InfinityTech100/Bike-Mini-speedo/Hardware/Bike/Bike1.png

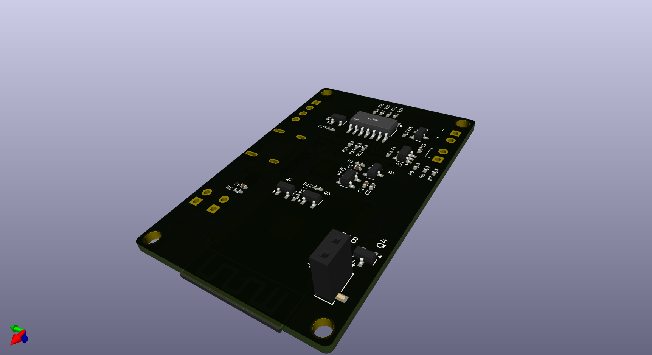
Hardware/Bike/Bike1.png
