InfinityTech100/Bike-Mini-speedo/Hardware/Bike/Bike2.png

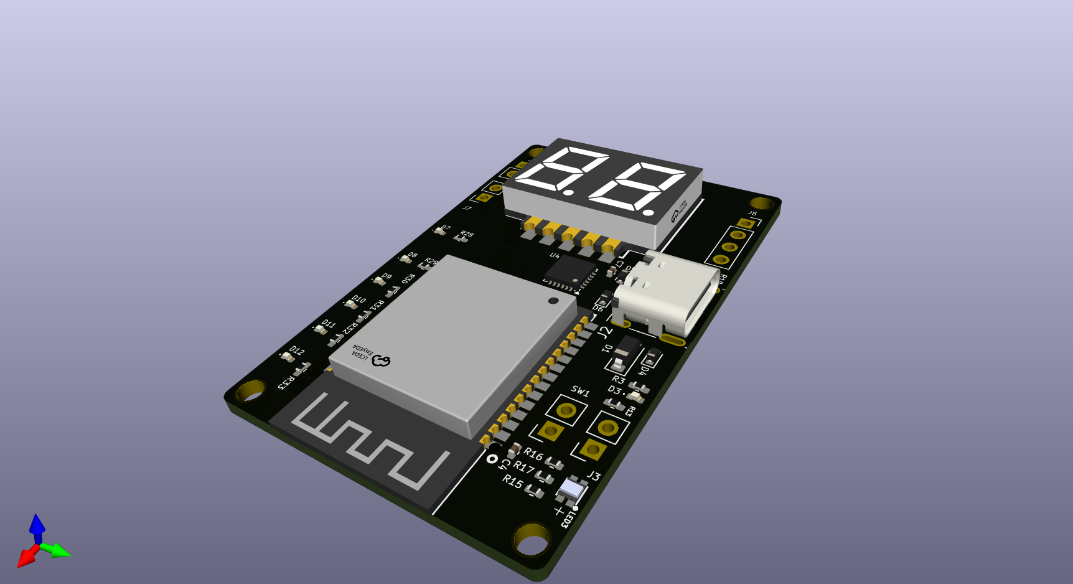
Hardware/Bike/Bike2.png
