InfinityTech100/Bike-Mini-speedo/Hardware/Bike/Bike3.png

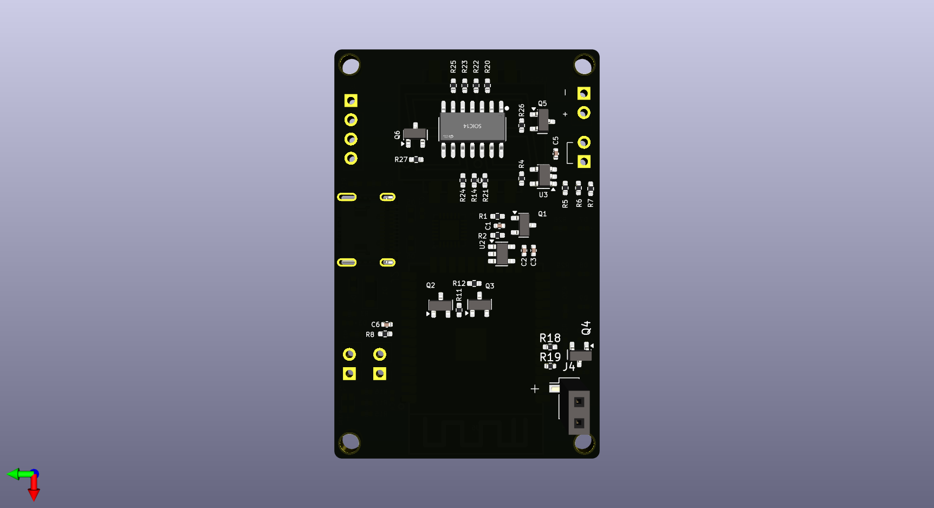
Hardware/Bike/Bike3.png
