InfinityTech100/Bike-Mini-speedo/Hardware/Bike/Bike4.png

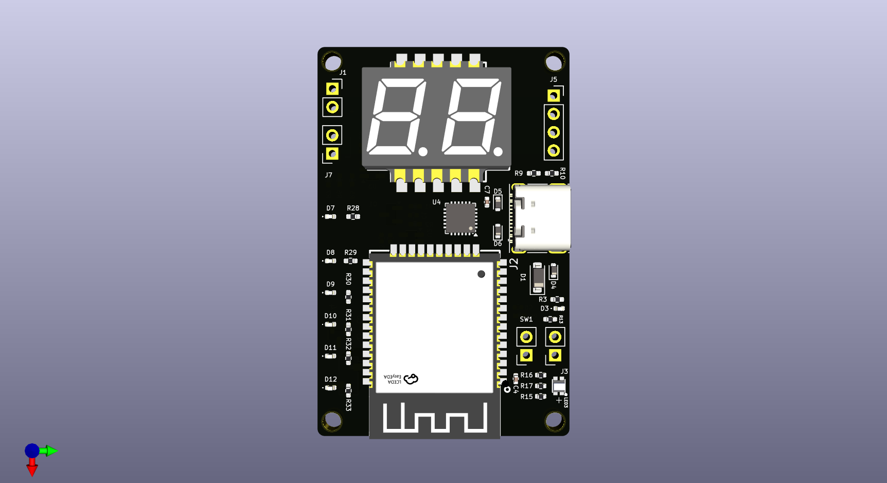
Hardware/Bike/Bike4.png
