InfinityTech100/Bike-Mini-speedo/Documents/BOM _v2.xlsx

Components | Size | Price | Qty | Total Price ($) | Link
Object Detection LED | 2.8 x 2.4 x 1.75 mm | 0.2 | 6 | 1.2 | https://www.lcsc.com/product-detail/Light-Emitting-Diodes-LED_Vishay-Intertech-VLMV3100-GS08_C2979783.html
Battery RGB LED | 3.5 x 3.5 x 1.9 | 0.1 | 1 | 0.1 | https://www.lcsc.com/product-detail/Light-Emitting-Diodes-LED_Worldsemi-WS2812B-MINI-V3-W_C527089.html
Digital LED | 19 x 25.1 x 3.85 mm | 5.18 | 1 | 5.18 | https://www.lcsc.com/product-detail/Led-Segment-Display_American-Opto-Plus-LED-SMC562LB-G-W_C6228974.html
GPS | 26 x 35 x 3 mm | 0.7 | 1 | 0.7 | https://ko.aliexpress.com/item/1005005396070425.html?src=google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
Buzzer | 5 x 5 x 2 mm | 0.5 | 1 | 0.5 | https://www.lcsc.com/product-detail/Buzzers_Jiangsu-Huaneng-Elec-MLT-5020_C94598.html
Battery 3.7V 1500mAh | 34 x 52 x 8 mm | 10 | 1 | 3 | https://www.coupang.com/vp/products/1988707178?itemId=3383782357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
PCB micro controller (ESP32-C3-WROOM-02-N4) | 25 x 18 x 3 mm | 2.78 | 1 | 2.78 | https://www.lcsc.com/product-detail/WiFi-Modules_Espressif-Systems-ESP32-C3-WROOM-02-N4_C2934560.html
Switch | 6 x 6 x 5 mm | 1 | 2 | 2 | https://www.lcsc.com/product-detail/Push-Switches_ALPSALPINE-SPEH110100_C97448.html
Total |  |  |  | 15.46 $
** yellow highlighted items will be attached manually
