InfinityTech100/Bike-Mini-speedo/Hardware/Bike/Bike.pdf

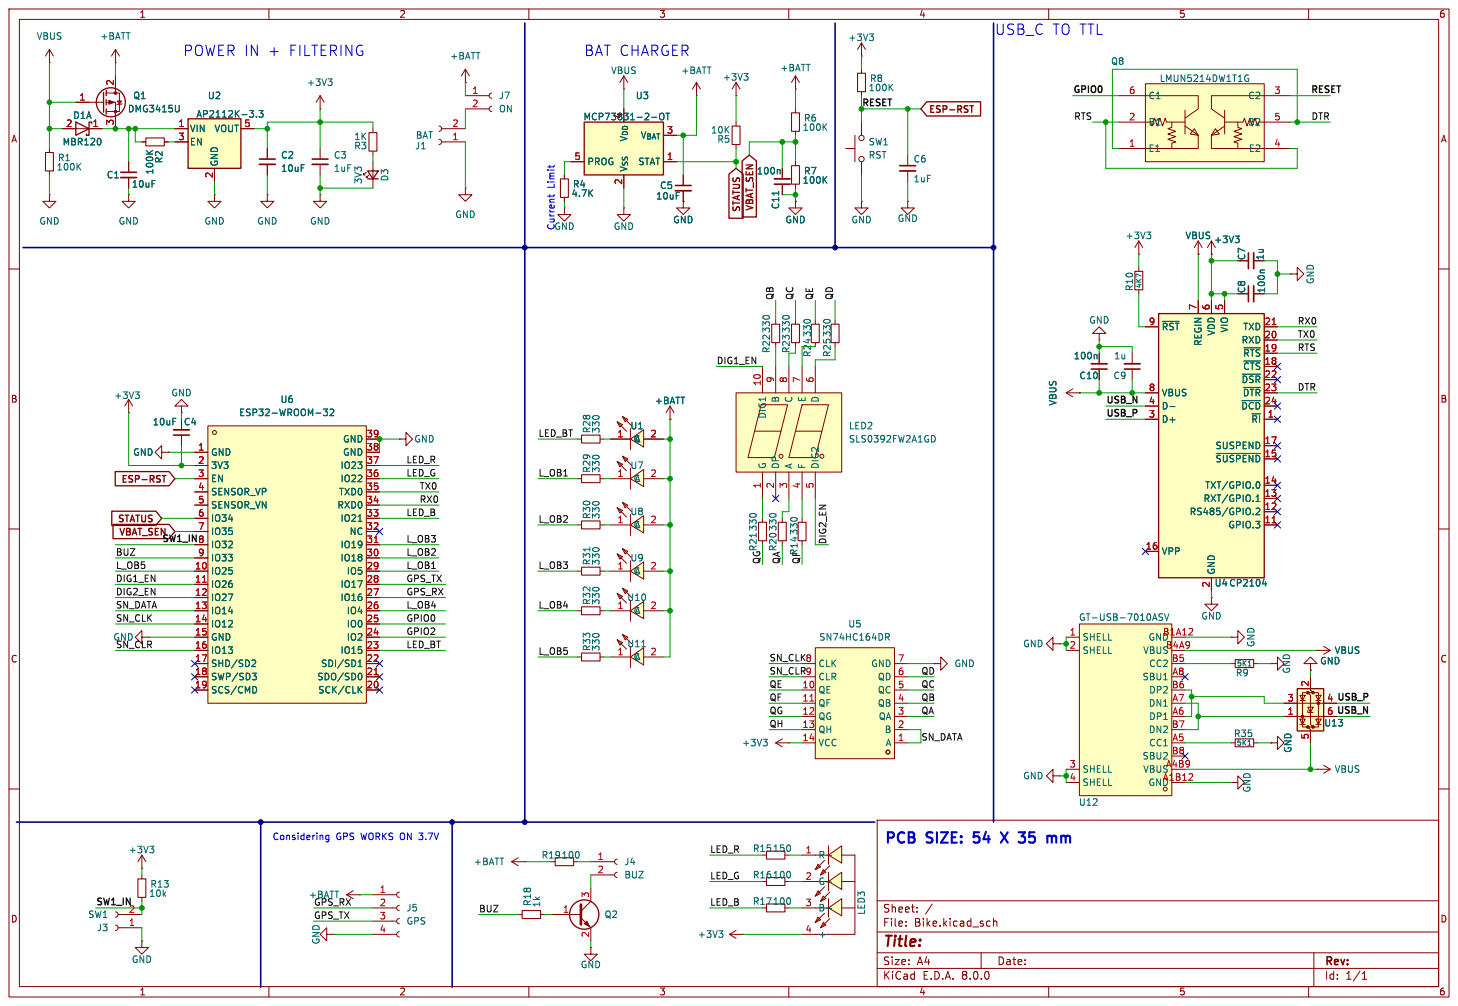
[picture p10: page 1]

BAT CHARGER Current Limit

7 VBUS 8 ~{RST} 9 U4 CP2104 GND GND

2 RXD 20 TXD 21 ~{DSR} 22 ~{DTR} 23 ~{DCD} 24 D+ 3 D- 4 VIO

IO13 16 SHD/SD2 17 SWP/SD3 18 SCS/CMD 19
