InfinityTech100/Bike-Mini-speedo/Hardware/Bike/Bike.kicad_pcb

## KiCad design Hardware/Bike/Bike.kicad_pcb (2024-05-11)

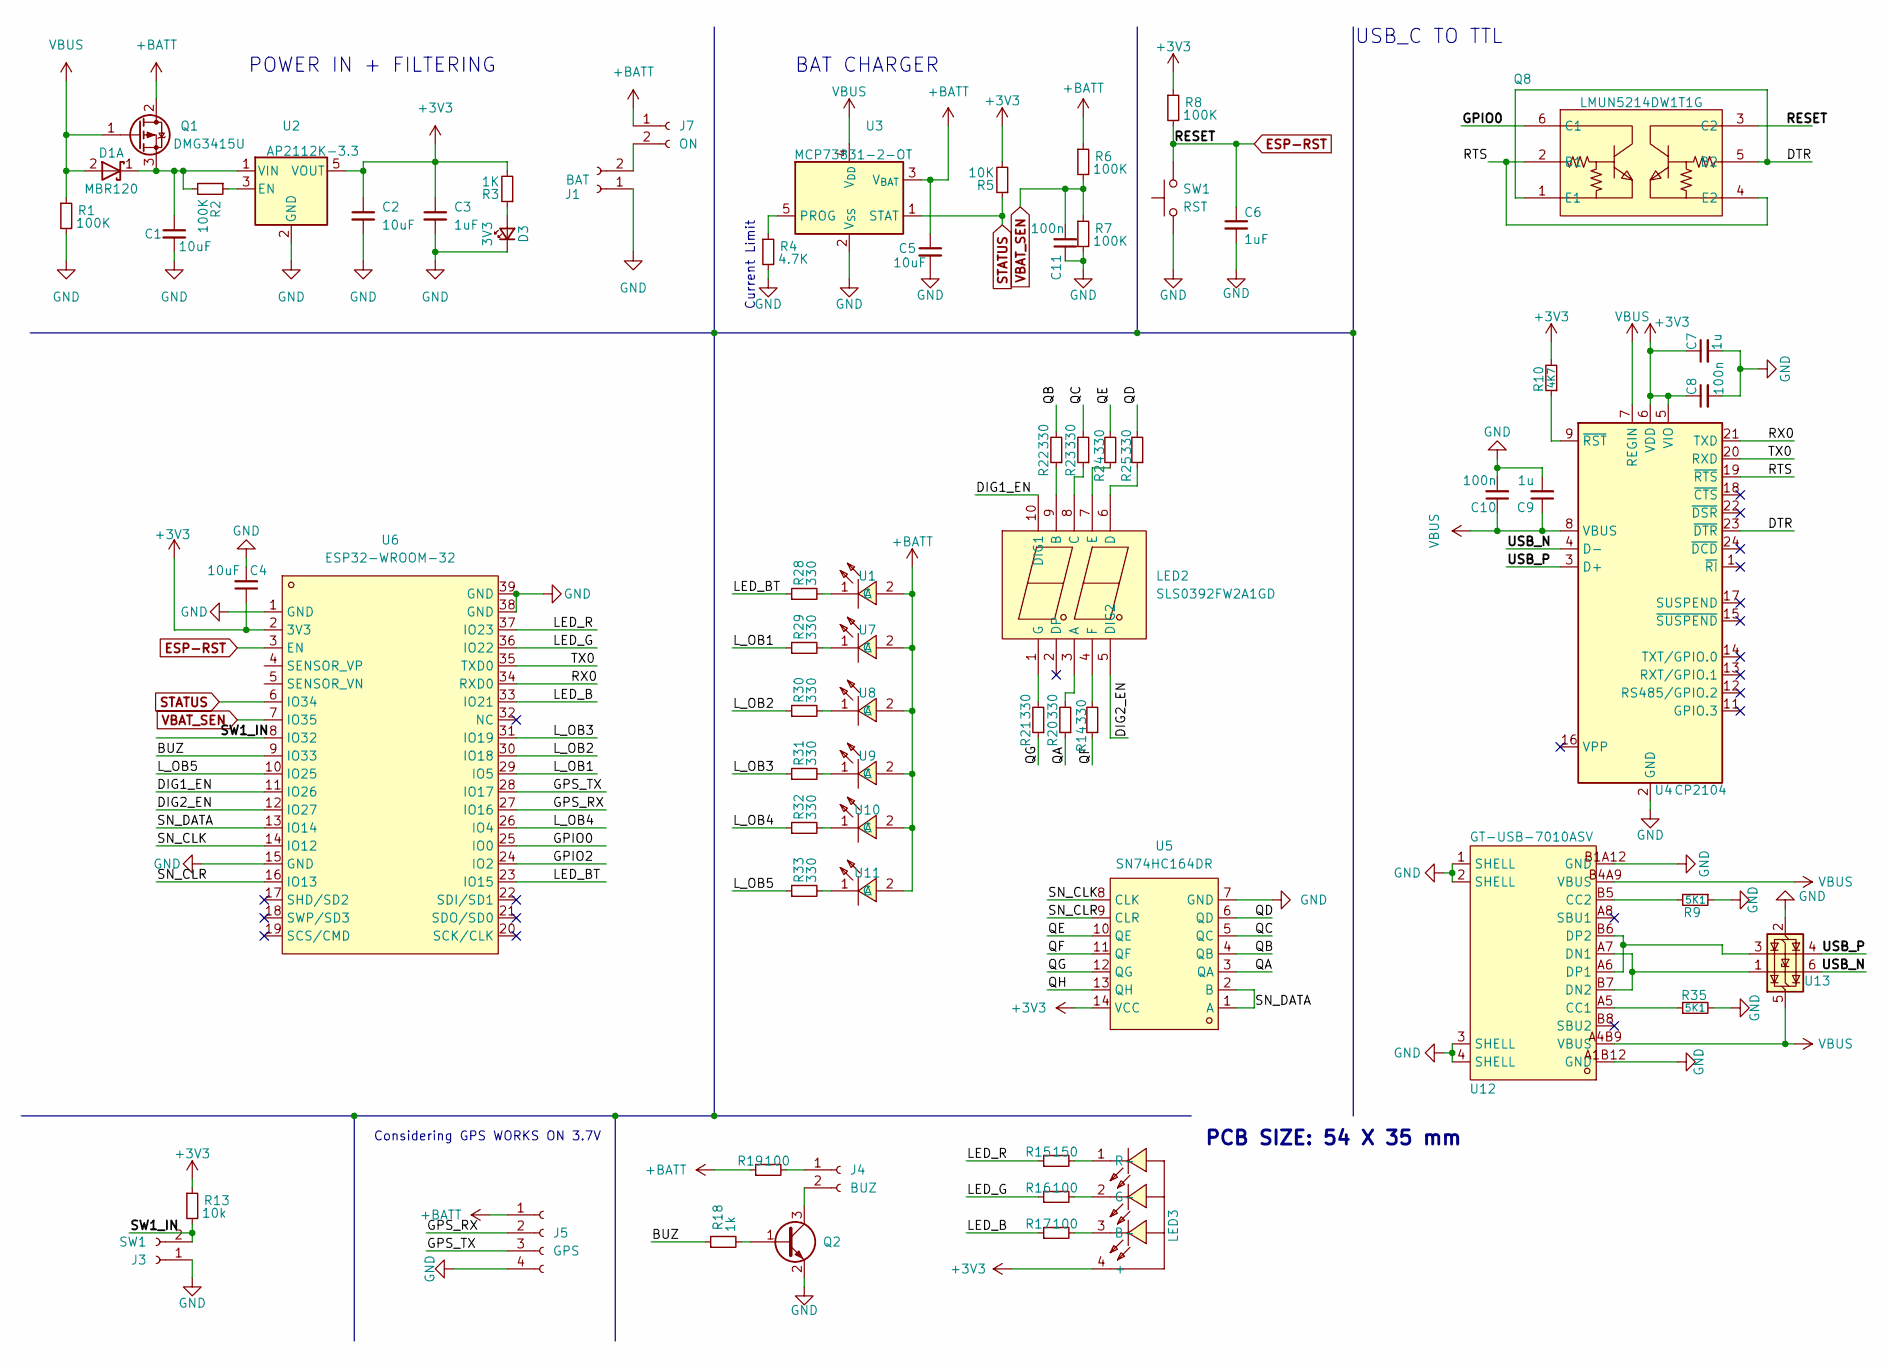
[picture p11: schematic Bike.kicad_sch]

Parts:
C1, C2, C4, C5: 10uF; C_0402_1005Metric
C3, C6: 1uF; C_0402_1005Metric
C7, C9: 1u; C_0402_1005Metric
C8, C10, C11: 100n; C_0402_1005Metric
D1: MBR120; D_SOD-123; LCSC C7422640
D3: 3V3; LED_0402_1005Metric
J1: BAT; PinSocket_1x02_P2.54mm_Vertical
J3: SW1; PinSocket_1x02_P2.54mm_Vertical
J4: BUZ; PinSocket_1x02_P2.54mm_Vertical_SMD_Pin1Left
J5: GPS; PinSocket_1x04_P2.54mm_Vertical
J7: ON; PinSocket_1x02_P2.54mm_Vertical
LED2: SLS0392FW2A1GD; LED-SEG-SMD_SLS0392FW2A1GD; LCSC Part C226001
LED3: 19-037A/RSGHBHW1-S03/2T; LED-ARRAY-SMD_4P-L1.6-W1.6-TR_EVERLIGHT_RSGHBHW1-S03; LCSC Part C282128
Q1: DMG3415U; SOT-23; LCSC C96616
Q2: Q_NPN_BEC; SOT-23-3
Q8: LMUN5214DW1T1G; SOT-363_L2.0-W1.3-P0.65-LS2.1-TL; LCSC Part C136173
R1, R2, R6, R7, R8: 100K; R_0402_1005Metric_Pad0.72x0.64mm_HandSolder
R3: 1K; R_0402_1005Metric_Pad0.72x0.64mm_HandSolder
R4: 4.7K; R_0402_1005Metric_Pad0.72x0.64mm_HandSolder
R5: 10K; R_0402_1005Metric_Pad0.72x0.64mm_HandSolder
R9, R35: 5K1; R_0402_1005Metric_Pad0.72x0.64mm_HandSolder
R10: 4K7; R_0402_1005Metric_Pad0.72x0.64mm_HandSolder
R13: 10k; R_0402_1005Metric_Pad0.72x0.64mm_HandSolder
R14, R20, R21, R22, R23, R24, R25, R28, R29, R30, R31, R32, R33: 330; R_0402_1005Metric_Pad0.72x0.64mm_HandSolder
R15: 150; R_0402_1005Metric; LCSC C445579
R16, R17, R19: 100; R_0402_1005Metric; LCSC C186115
R18: 1k; R_0402_1005Metric_Pad0.72x0.64mm_HandSolder
SW1: RST; PinSocket_1x02_P2.54mm_Vertical
U1: APTD3216SECK; LED1206-RD; LCSC Part C5569593
U2: AP2112K-3.3; SOT-23-5; LCSC C3021085
U3: MCP73831-2-OT; SOT-23-5
U4: CP2104; QFN-24-1EP_4x4mm_P0.5mm_EP2.6x2.6mm; LCSC C47742
U5: SN74HC164DR; SOIC-14_L8.7-W3.9-P1.27-LS6.0-BL; LCSC Part C5419
U6: ESP32-WROOM-32; WIFIM-SMD_ESP32-WROOM-32-N4; LCSC Part C82899
U7, U8, U9, U10, U11: APTD3216SECK; LED1206-RD; LCSC Part C5879029
U12: GT-USB-7010ASV; USB-C-SMD_G-SWITCH_GT-USB-7010ASV; LCSC Part C2988369
U13: USBLC6-2P6; SOT-666; LCSC C2827693

Connections:
+3V3: C2.1, C3.1, C4.1, C7.1, C8.1, LED3.4 (+), R3.2, R5.2, R8.1, R10.2, R13.1, U2.5 (VOUT), U4.5 (VIO), U4.6 (VDD), U5.14 (VCC), U6.2 (3V3)
+BATT: C5.1, J5.1, J7.1, Q1.2 (D), R6.1, R19.1, U1.2 (A), U3.3 (V_{BAT}), U7.2 (A), U8.2 (A), U9.2 (A), U10.2 (A), U11.2 (A)
/BUZ: R18.1, U6.9 (IO33)
/DIG1_EN: LED2.10 (DIG1), U6.11 (IO26)
/DIG2_EN: LED2.5 (DIG2), U6.12 (IO27)
/DTR: Q8.1 (E1), Q8.5 (B2), U4.23 (~DTR)
/GPIO0: Q8.6 (C1), U6.25 (IO0)
/GPIO2: U6.24 (IO2)
/GPS_RX: J5.2, U6.27 (IO16)
/GPS_TX: J5.3, U6.28 (IO17)
/LED_B: R17.1, U6.33 (IO21)
/LED_BT: R28.1, U6.23 (IO15)
/LED_G: R16.1, U6.36 (IO22)
/LED_R: R15.1, U6.37 (IO23)
/L_OB1: R29.1, U6.29 (IO5)
/L_OB2: R30.1, U6.30 (IO18)
/L_OB3: R31.1, U6.31 (IO19)
/L_OB4: R32.1, U6.26 (IO4)
/L_OB5: R33.1, U6.10 (IO25)
/QA: R20.1, U5.3 (QA)
/QB: R22.2, U5.4 (QB)
/QC: R23.2, U5.5 (QC)
/QD: R25.2, U5.6 (QD)
/QE: R24.2, U5.10 (QE)
/QF: R14.1, U5.11 (QF)
/QG: R21.1, U5.12 (QG)
/QH: U5.13 (QH)
/RTS: Q8.2 (B1), Q8.4 (E2), U4.19 (~RTS)
/RX0: U4.21 (TXD), U6.34 (RXD0)
/SN_CLK: U5.8 (CLK), U6.14 (IO12)
/SN_CLR: U5.9 (CLR), U6.16 (IO13)
/SN_DATA: U5.1 (A), U5.2 (B), U6.13 (IO14)
/SW1_IN: J3.2, R13.2, U6.8 (IO32)
/TX0: U4.20 (RXD), U6.35 (TXD0)
/USB_N: U4.4 (D-), U13.6 (I/O1)
/USB_P: U4.3 (D+), U13.4 (I/O2)
ESP-RST: C6.1, Q8.3 (C2), R8.2, SW1.2, U6.3 (EN)
GND: C1.2, C2.2, C3.2, C4.2, C5.2, C6.2, C7.2, C8.2, C9.2, C10.2, C11.1, D3.1 (K), J1.1, J3.1, J5.4, Q2.2 (E), R1.2, R4.2, R7.2, R9.1, R35.2, SW1.1, U2.2 (GND), U3.2 (V_{SS}), U4.2 (GND), U4.25 (GND), U5.7 (GND), U6.1 (GND), U6.15 (GND), U6.38 (GND), U6.39 (GND), U12.1 (SHELL), U12.2 (SHELL), U12.3 (SHELL), U12.4 (SHELL), U12.A1B12 (GND), U12.B1A12 (GND), U13.2 (GND)
unnamed: C1.1, D1.1 (K), Q1.3 (S), R2.2, U2.1 (VIN)
unnamed: D3.2 (A), R3.1
unnamed: J1.2, J7.2
unnamed: J4.1, R19.2
unnamed: J4.2, Q2.3 (C)
unnamed: LED2.3 (A), R20.2
unnamed: LED2.9 (B), R22.1
unnamed: LED2.8 (C), R23.1
unnamed: LED2.6 (D), R25.1
unnamed: LED2.7 (E), R24.1
unnamed: LED2.4 (F), R14.2
unnamed: LED2.1 (G), R21.2
unnamed: LED3.3 (B-), R17.2
unnamed: LED3.2 (G-), R16.2
unnamed: LED3.1 (R-), R15.2
unnamed: Q2.1 (B), R18.2
unnamed: R28.2, U1.1 (C)
unnamed: R2.1, U2.3 (EN)
unnamed: R4.1, U3.5 (PROG)
unnamed: R10.1, U4.9 (~RST)
unnamed: R29.2, U7.1 (C)
unnamed: R30.2, U8.1 (C)
unnamed: R31.2, U9.1 (C)
unnamed: R32.2, U10.1 (C)
unnamed: R33.2, U11.1 (C)
unnamed: R35.1, U12.A5 (CC1)
unnamed: R9.2, U12.B5 (CC2)
unnamed: U12.A7 (DN1), U12.B7 (DN2), U13.1 (I/O1)
unnamed: U12.A6 (DP1), U12.B6 (DP2), U13.3 (I/O2)
STATUS: R5.1, U3.1 (STAT), U6.6 (IO34)
VBAT_SEN: C11.2, R6.2, R7.1, U6.7 (IO35)
VBUS: C9.1, C10.1, D1.2 (A), Q1.1 (G), R1.1, U3.4 (V_{DD}), U4.7 (REGIN), U4.8 (VBUS), U12.A4B9 (VBUS), U12.B4A9 (VBUS), U13.5 (VBUS)

Notes on the sheet:
PCB SIZE: 54 X 35 mm
Current Limit
USB_C TO TTL
Considering GPS WORKS ON 3.7V
BAT CHARGER
POWER IN + FILTERING

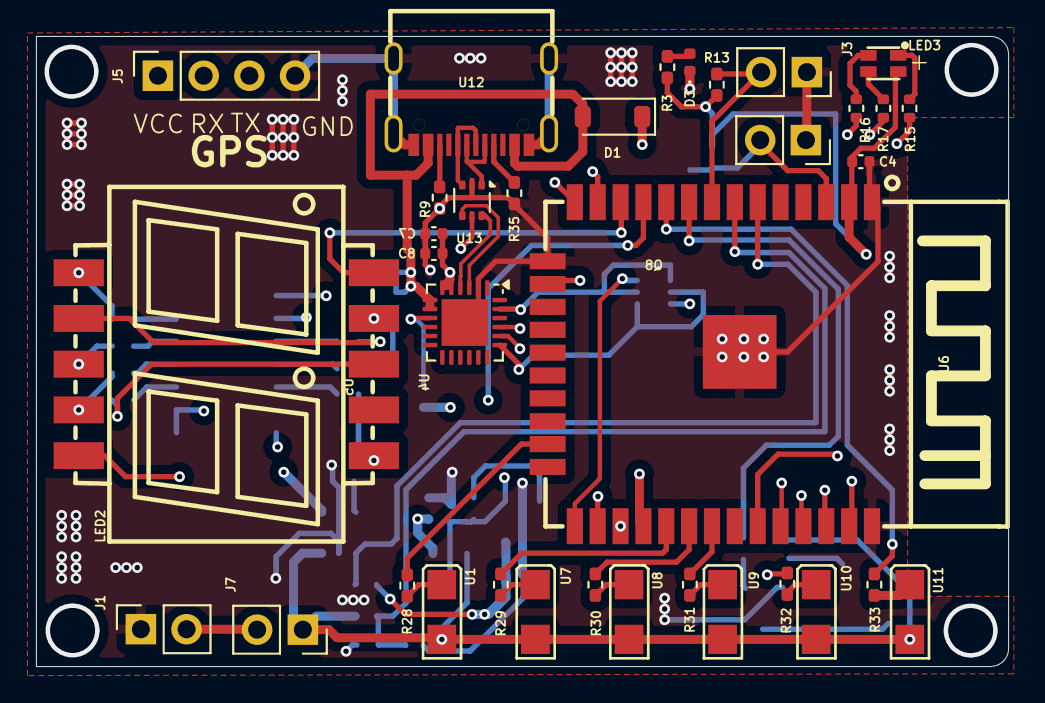
[picture p12: board Bike.kicad_pcb from above]

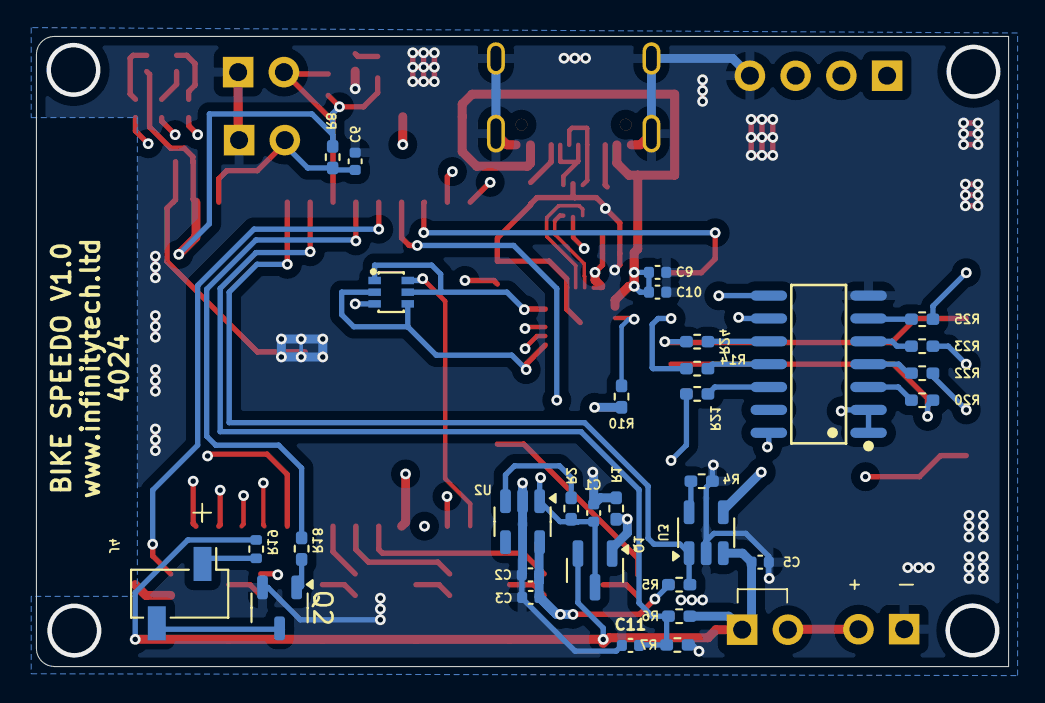
[picture p13: board Bike.kicad_pcb from below]

Board: 4 copper layers, 54.0 x 35.0 mm, 67 parts (32 on the bottom side), 68 nets.
