InfinityTech100/Bike-Mini-speedo/(commit log)

2024-03-07 Hardware Schematic
    [Bike.kicad_pcb, Bike.kicad_sch]
2024-03-07 Updated Schematic
    [Bike.kicad_sch]
2024-03-07 adde schematic as pdf
2024-03-12 schematics design
    [BOM _v2.xlsx, Bike.kicad_sch, Bike_mamdouh.kicad_sch]
2024-03-16 Added the 74H595 shift register to HW schematic and tested the 2digit 7segmments using the shitf register
    [V2_sch.kicad_sch]
2024-03-25 made leds states changeable
2024-04-02 Urad3 V2 Fixed battery & drawer menu Bug
    [Bike.kicad_sch, Bike_mamdouh.kicad_sch, V2_sch.kicad_sch]
2024-04-29 hardware done
    [Bike.kicad_pcb, Bike.kicad_sch, bom.csv, designators.csv, positions.csv]
2024-05-02 Finished unite Testing all pcb components & added the Bike v1 code
    [bom.csv, designators.csv, positions.csv]
2024-05-11 fixing testing note
    [Bike.kicad_pcb, Bike.kicad_sch, Bike_mamdouh.kicad_sch, V2_sch.kicad_sch, bom.csv, designators.csv, positions.csv]
